HellSquirrel/wheely/docs/parts/tt_motor_diagram.jpg

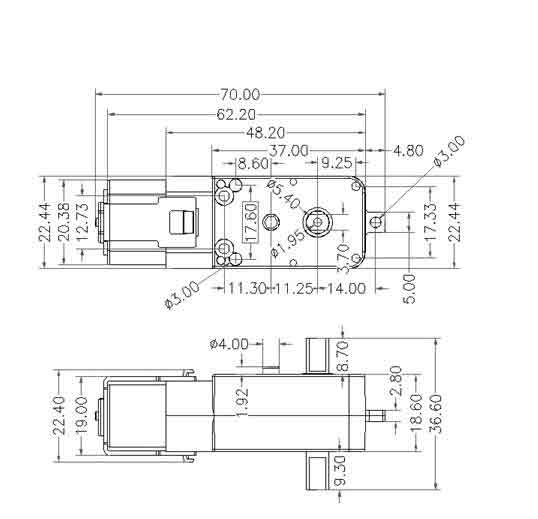
docs/parts/tt_motor_diagram.jpg
