HellSquirrel/wheely/hardware/wheely_sonar_bracket_v16.stl

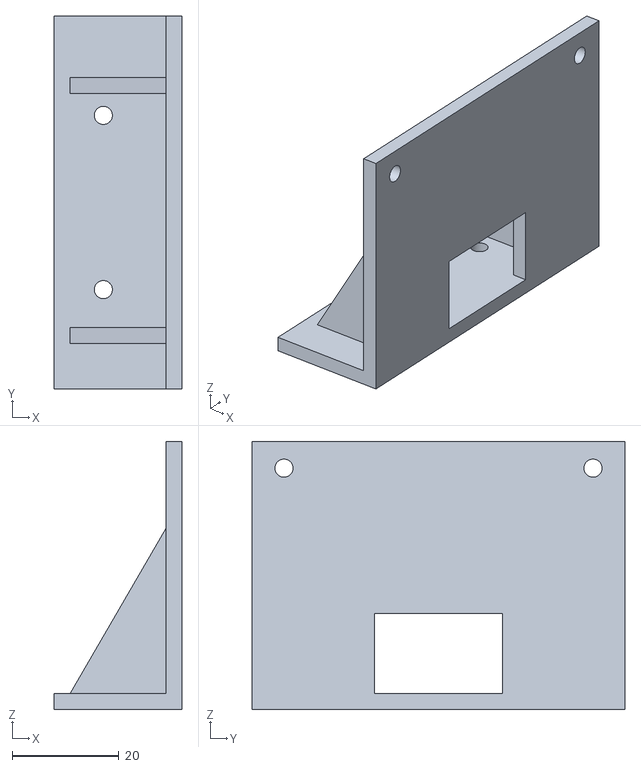
[picture p2: CAD file, 2026-10-10]
hardware/wheely_sonar_bracket_v16.stl
24.0 x 70.0 x 50.3
