HellSquirrel/wheely/hardware/sonar_holder_standalone.stl

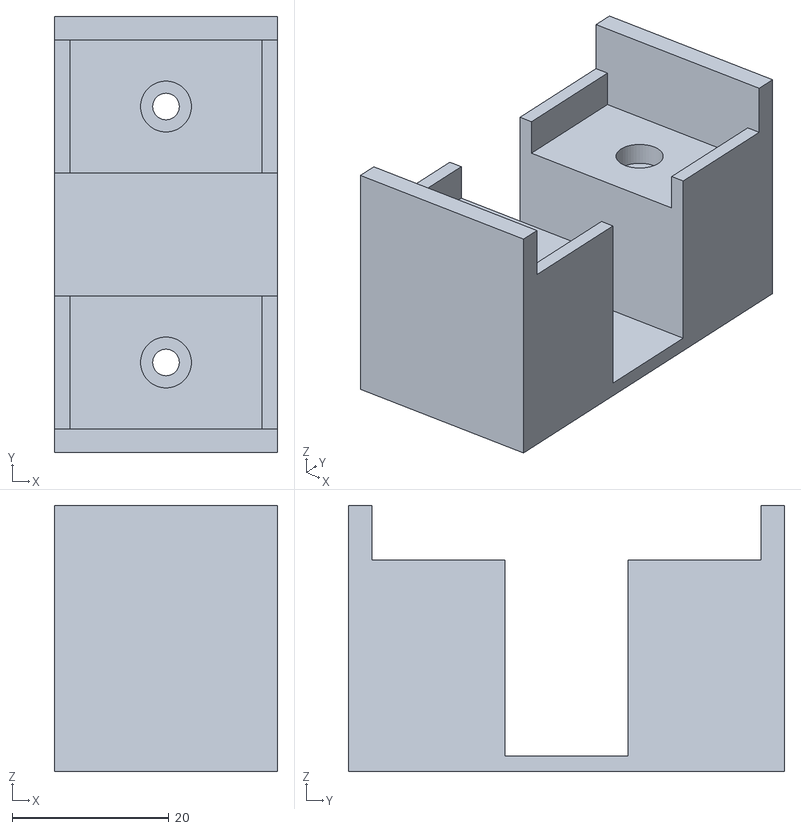
[picture p3: CAD file, 2026-10-10]
hardware/sonar_holder_standalone.stl
28.5 x 55.7 x 34.0
