HellSquirrel/wheely/hardware/wheely_chassis_v15.stl

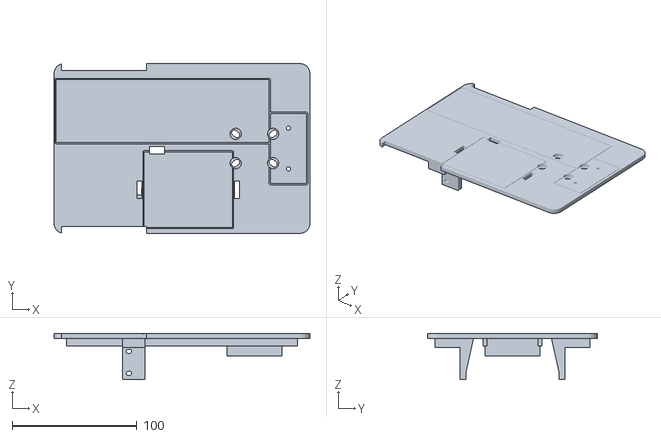
[picture p4: CAD file, 2026-10-10]
hardware/wheely_chassis_v15.stl
205.0 x 136.0 x 37.0
