HellSquirrel/wheely/hardware/wheely_sonar_holder_standalone_v14.stl

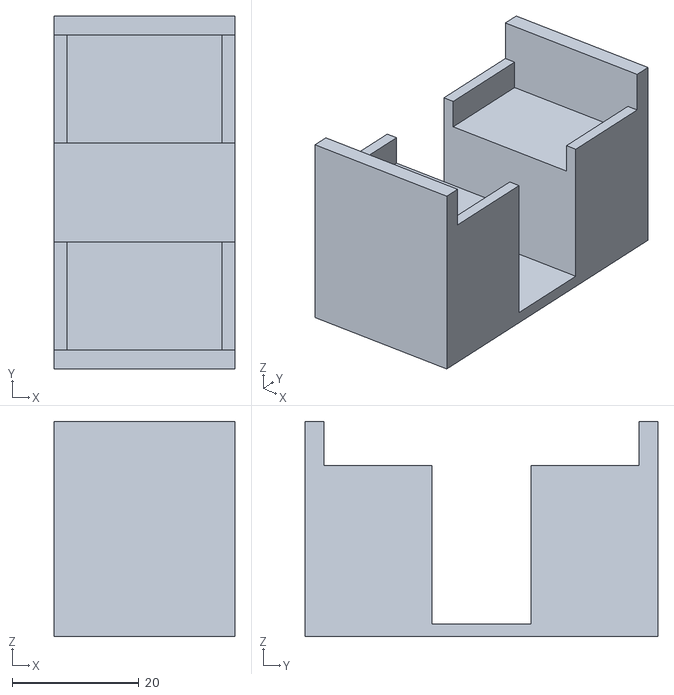
[picture p5: CAD file, 2026-10-10]
hardware/wheely_sonar_holder_standalone_v14.stl
28.5 x 55.7 x 34.0
