HellSquirrel/wheely/hardware/sonar_cradle_test.stl

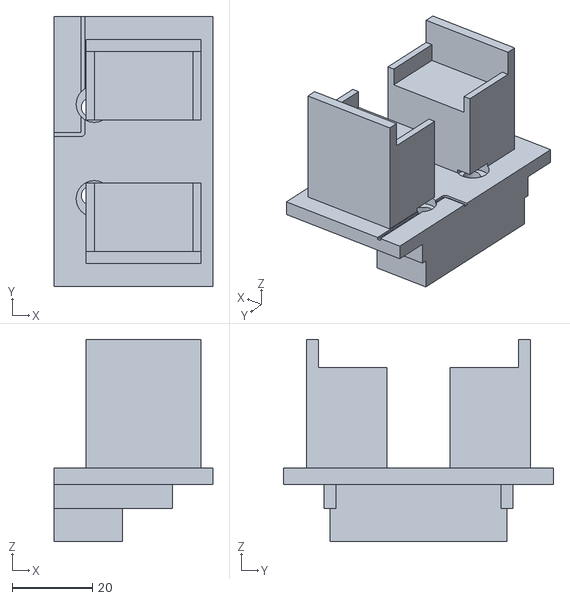
[picture p6: CAD file, 2026-10-10]
hardware/sonar_cradle_test.stl
39.5 x 67.2 x 50.2
