HellSquirrel/wheely/hardware/chassis.stl

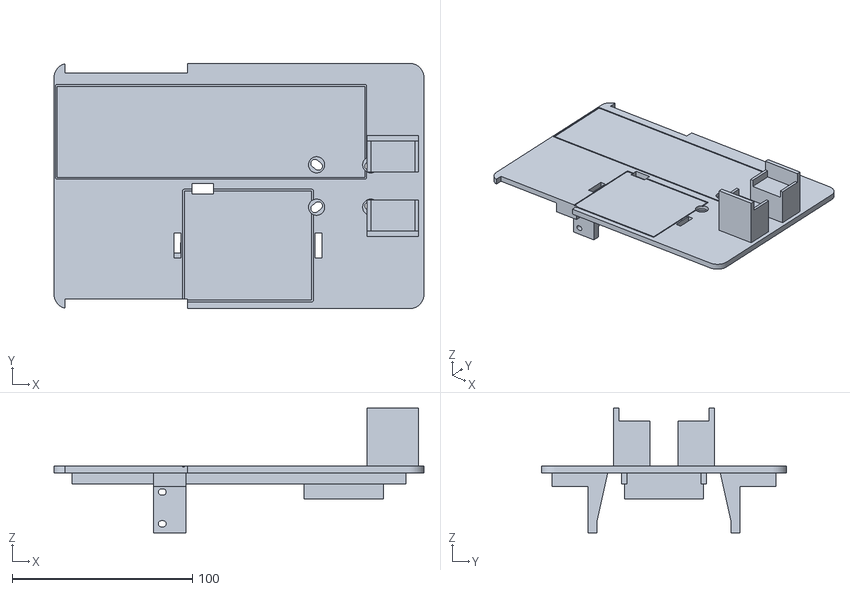
[picture p7: CAD file, 2026-10-10]
hardware/chassis.stl
205.0 x 136.0 x 69.0
