HellSquirrel/wheely/hardware/wheely_sonar_cradle_v13.stl

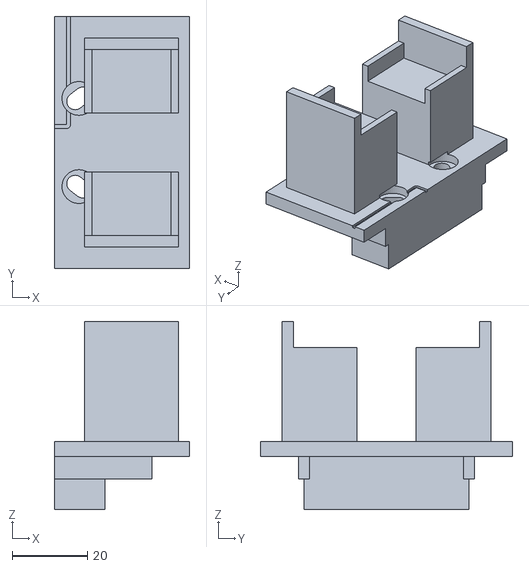
[picture p8: CAD file, 2026-10-10]
hardware/wheely_sonar_cradle_v13.stl
36.0 x 67.2 x 50.2
