HellSquirrel/wheely/hardware/wheely_caster_mount_v11.stl

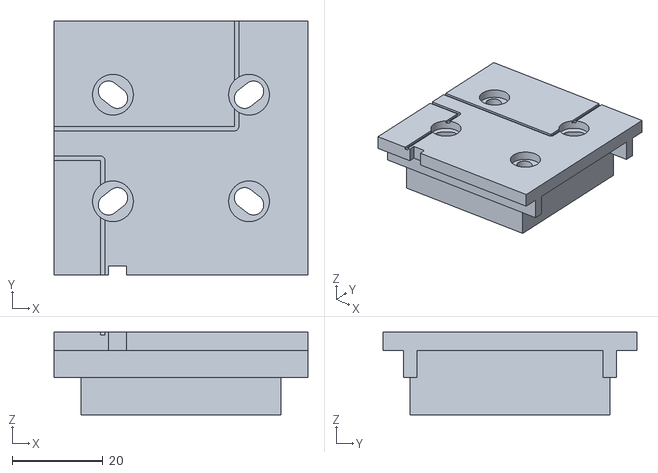
[picture p9: CAD file, 2026-10-10]
hardware/wheely_caster_mount_v11.stl
56.0 x 56.0 x 18.2
