HellSquirrel/wheely/hardware/wheely_motor_mount_v11.stl

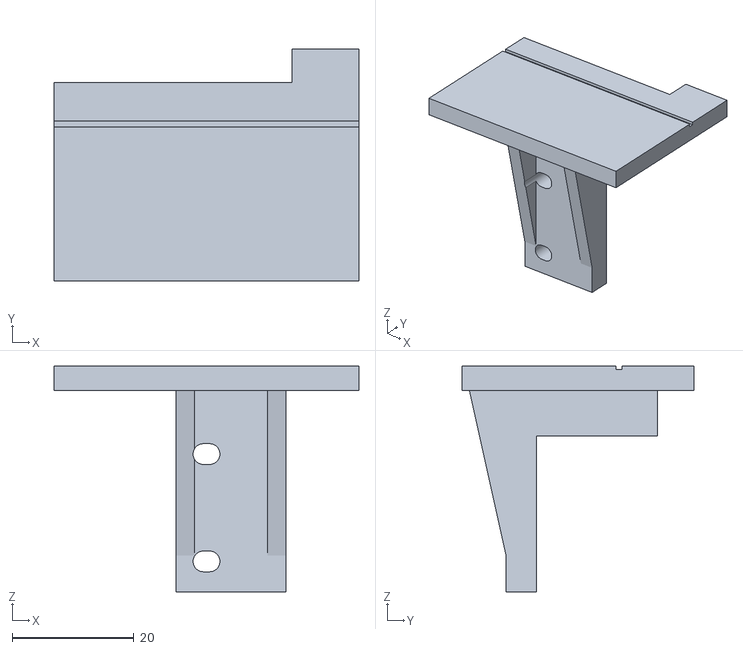
[picture p10: CAD file, 2026-10-10]
hardware/wheely_motor_mount_v11.stl
50.0 x 38.0 x 37.0
