HellSquirrel/wheely/hardware/motor_mount_test.stl

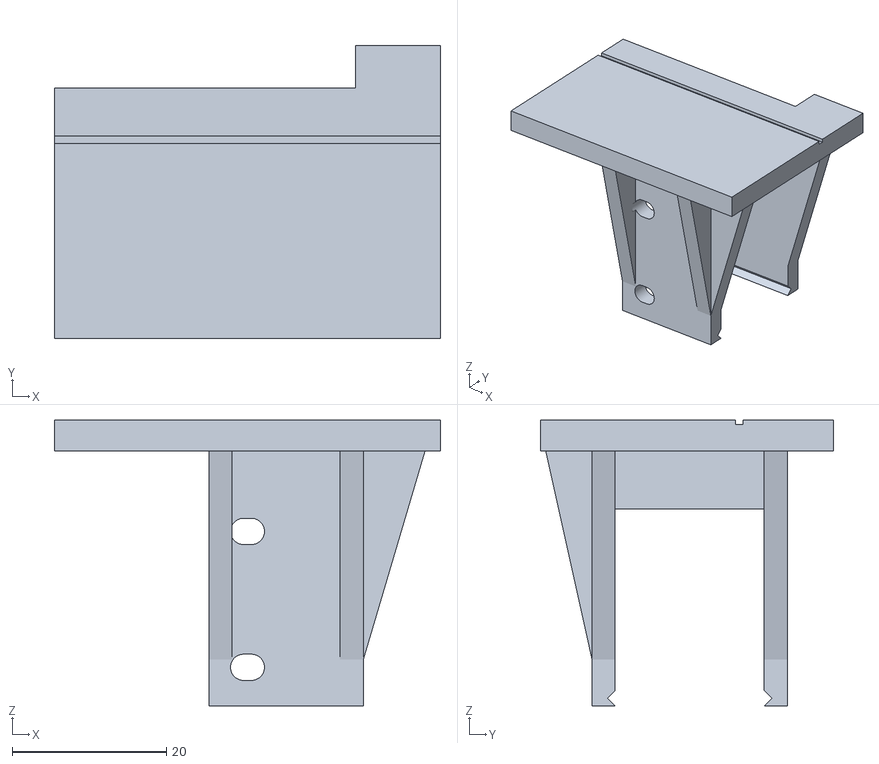
[picture p11: CAD file, 2026-10-09]
hardware/motor_mount_test.stl
50.0 x 38.0 x 37.0
