HellSquirrel/wheely/hardware/wheely_sonar_cradle_v12.stl

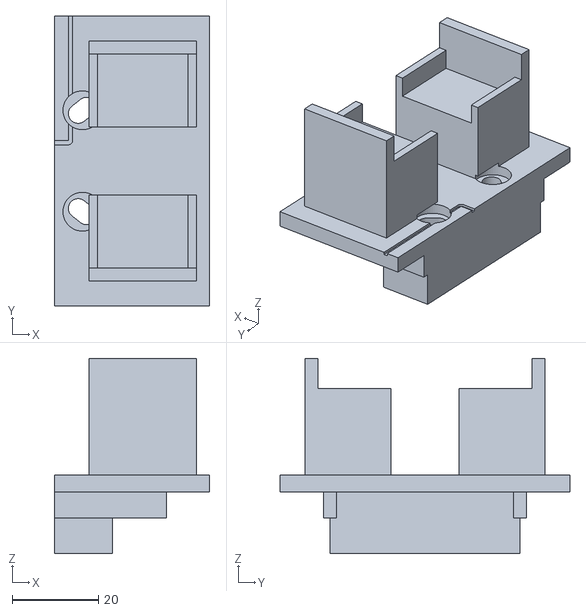
[picture p12: CAD file, 2026-10-10, an earlier design]
hardware/wheely_sonar_cradle_v12.stl
36.0 x 67.2 x 45.2
