HellSquirrel/wheely/hardware/wheely_motor_mount_v10.stl

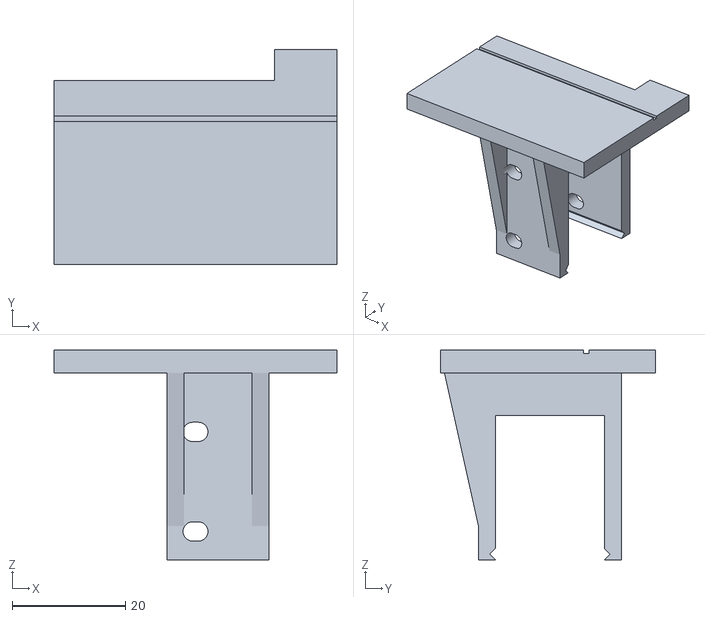
[picture p13: CAD file, 2026-10-10, an earlier design]
hardware/wheely_motor_mount_v10.stl
50.0 x 38.0 x 37.0
