HellSquirrel/wheely/(commit log)

2026-10-07 Pico 2 W + Embassy robot: sonar, DRV8833 motor, drive-and-stop
    Rust/Embassy firmware for a 2WD robot on a Raspberry Pi Pico 2 W (RP2350).
    Flashed over USB with picotool (BOOTSEL), logs over USB CDC via
    embassy-usb-logger; defmt/RTT kept for when the Debug Probe is used.
    Library (src/lib.rs):
    - sonar: RCWL-1601 ranging with timeouts and a fault enum
    - motor: DRV8833 motor on one PWM slice, slow-decay PWM at 20 kHz
    Binaries (src/bin):
    - drive: milestone 3, drive forward and coast under 20 cm (resume over
    30 cm), sonar task -> Signal -> motor loop; verified on the bench with
    one motor
    - sonar, motor: single-subsystem tests
    - sonar_diag, probe, bisect: bench diagnostics (pin-orientation ch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
2026-10-09 Parametric printed chassis draft (OpenSCAD) + TT motor drawing
    hardware/chassis.scad: single-plate PLA chassis, TT motors on gusseted
    ears under the plate (bolt geometry from the Adafruit 3777 drawing),
    wheel wells, counterbored caster bolts, breadboard side rails, battery
    bay with strap slots, two ribs. Breadboard and battery sizes measured;
    wheel, caster and sonar holder dimensions are still placeholders.
    hardware/chassis.stl: current export.
2026-10-09 Chassis: 60x30 wheels, breadboard to the front edge, sonar case rides the breadboard
    The printed sonar case (i-Boxlt Bread Board Mount, read from the 3MF) has no
    screw holes and stands on the sensor's own pins in breadboard rows, so the
    plate loses its sonar holes and the breadboard moves to the front edge.
    Preview ghosts for breadboard, sonar case and battery holder.
2026-10-09 Chassis: caster from photos (slotted 30x30 pattern, 41 mm), plate +2 mm, battery wire notch
    Claude-Session: https://claude.ai/code/session_0142WXAPj1NqXsacr8WTvvFs
2026-10-09 Chassis: flat top face for support-free printing (lips off, outline grooves instead)
    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
2026-10-09 Chassis v5: motor mount rebuilt after first print
    - Ears tied by a saddle block over the gearbox; gussets along X; wheel well
    moved outboard of the outer ear (it had cut into the ear's footprint).
    - Mounting holes are on the motor-can side of the shaft (drawing misread):
    ears now sit 11.25 mm in front of the shaft, can points forward.
    - Bolt holes run through the full mount width (the upper hole was blind).
    - motor_mount_test.scad: one mount on a patch of plate as a quick test print.
    Caster hole pattern still wrong; awaiting measurement.
    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
2026-10-09 Chassis: front sonar cradle (towers + open connector channel), breadboard moved to the rear
    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
2026-10-09 Chassis v6: measured caster (30x23.5 slots, 35 mm), sonar cradle sized to the case
    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
2026-10-09 Chassis v7: ears clear the motor pegs, slotted bolt holes, 19.4 mm pocket
    SparkFun DG01D drawing (docs/parts) shows the M3 holes ~20.6 mm from the
    shaft on the can side and O4 pegs at ~11 mm; Adafruit's drawing says 22.5
    for the holes. Ears now span 15..35 mm from the shaft with 4 mm slots
    centred at 21.5, so either is fine and the pegs no longer hit the ears.
    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
2026-10-09 Chassis v8: motor bolt holes at the measured 20 mm from the shaft
    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
2026-10-09 Chassis v9: nothing behind the motor ears (rear gussets removed), 7.5 mm saddle, plate +4 mm
    The motor's O4 pegs sit 8..12 mm from the shaft on both faces. The rear
    gussets, drawn in the ear planes, reached back to ~12 mm at peg height.
    Front gussets only now, inboard fins on the inner ear, and the plate rises
    4 mm so the saddle block over the gearbox is 7.5 mm thick.
    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
2026-10-10 Chassis v10: no gussets in the motor ear planes (can collided), ears 15..33
    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
2026-10-10 Chassis v11: single-sided motor mount (5 mm inboard ear, through-bolts, nuts inboard)
    The gearbox sat on top of the two-ear pocket: clone gearbox width varies and
    the 19.4 mm pocket was too tight. One inboard ear, bolts through ear and
    gearbox with heads on the wheel side, so the gearbox width can't matter and
    the wheel keeps the full shaft.
    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
2026-10-10 Test coupons for the caster mount and the sonar cradle
    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
2026-10-10 Sonar cradle: pocket depth 21 mm (case deeper than the 19 mm estimate)
    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
2026-10-10 Sonar cradle: towers 20 mm (case raised 5 mm)
    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
2026-10-10 Sonar cradle: 24 mm case depth (outside), pocket 24.5
    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
2026-10-10 Standalone sonar holder part (cradle on a 2 mm base, no plate, no holes)
    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
2026-10-10 Chassis v14: final plate export after all coupons passed
    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
2026-10-10 Chassis v15: sonar cradle split into a bolt-on part so the plate's top face is flat
    The plate prints top-face-down; a cradle on the top face would need supports.
    Two M3 holes through the plate at the tower centres, matching holes with head
    recesses in the standalone cradle (or skewers + glue).
    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
2026-10-10 Assembly preview model (plate + cradle + parts in place)
    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
2026-10-10 Sonar: hinged-case bracket (v16) + modified hinged case with 22.5 mm transducer centres
    The user switched to MakerWorld model 1913595 (hinged HC-SR04 case). Its back has two
    ears with O4 holes 58 mm apart, 25.3 mm above the case's bottom edge, so the front
    mount is now an upright face with those holes, a wire window below, and a foot on the
    plate's existing two cradle holes. The v15 plate is unchanged. The case itself is
    modified (openings moved 1.75 mm inboard each) for the RCWL-1601's 22.5 mm spacing.
    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
2026-10-15 Bluetooth remote: drive wheely from a phone over BLE
    - remote binary: Nordic UART Service, Bluefruit Connect control pad (hold to move,
    1-4 speed presets) or single-letter commands; 50 ms control loop; 5 s max hold;
    sonar blocks forward only (20/30 cm hysteresis + 3-reading clear debounce);
    disconnect stops; 1 Hz status notify; "boot" reboots into BOOTSEL for flashing.
    - ble_test binary: advertise + log received bytes (verified on hardware).
    - CYW43439 firmware blobs (Wi-Fi, CLM, Bluetooth, NVRAM) + licence in firmware/.
    - Pin all embassy crates to git rev 3cd51e6 so cyw43 0.7 and trouble-host 0.8
    agree on bt-hci; version numbers unchanged, old binaries still build.
    - Motor sides con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
2026-10-15 Web Bluetooth PWA remote (web/): control pad, keyboard, speed presets, telemetry, installable
    Same Nordic UART Service and Bluefruit control-pad packets as the phone app, so no
    firmware change. Verified driving wheely from desktop Chrome on 2026-10-15.
    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
2026-10-16 Cruise mode (obstacle avoidance) and Wi-Fi telemetry for mapping
    - wheely::cruise: forward / back / spin / settle state machine; spin doubles on quick
    repeats, flips direction after two; cancelled by any arrow, stop, disconnect or a
    faulty sonar. Command 'c' over BLE, Cruise button + C key in the web app.
    - Wi-Fi (embassy-net, DHCP): broadcasts one JSON sample per 100 ms on UDP 4210 with
    uptime, sonar, gate, command, cruise phase and wheel speeds. Credentials from a
    gitignored wifi.secrets read by build.rs (quotes tolerated). On a failed join the
    firmware scans and logs visible networks; auth mode rotates mixed/WPA2/WPA3.
    - tools/telemetry.py (CSV logger) and tools/map.py (dead-rec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
2026-10-16 README: handoff for the finished prototype (hardware, wiring, firmware, tools, workflows, gotchas)
    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
2026-10-16 docs: wheely v2 parts list
    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
2026-10-16 docs: v2 parts, proper connectors for the switch and every off-board part
    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
2026-10-16 docs: v2 order checklist (md + printable pdf)
    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
2026-10-16 docs: v2 order, M3 only; boards held by the printed chassis
    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
2026-10-16 docs: v2 order, battery and charger sourcing, motor supply from VBAT
    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
2026-10-16 docs: v2 order, PKCell battery from The Pi Hut
    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
